JohnWSatterfield/Atlas_210X_Digital_VFO/Manual/readme

Atlas 210X Drake TR7 Crystal Filter.pdf is the name of the manual and instruction on how to convert your Atlas 210X to use a digital VFO.
CF.jpg is my drawing of the Drake crystal filter along with the parameters I selected for programming the microcontroller
Display_Bracket_Scale.pdf is a scaled pdf drawing that you can print to make the display bracket to mount the display into the radio,
and add the needed circuit boards.
