JohnWSatterfield/Atlas_210X_Digital_VFO/Manual/Display_Bracket_Scale.pdf

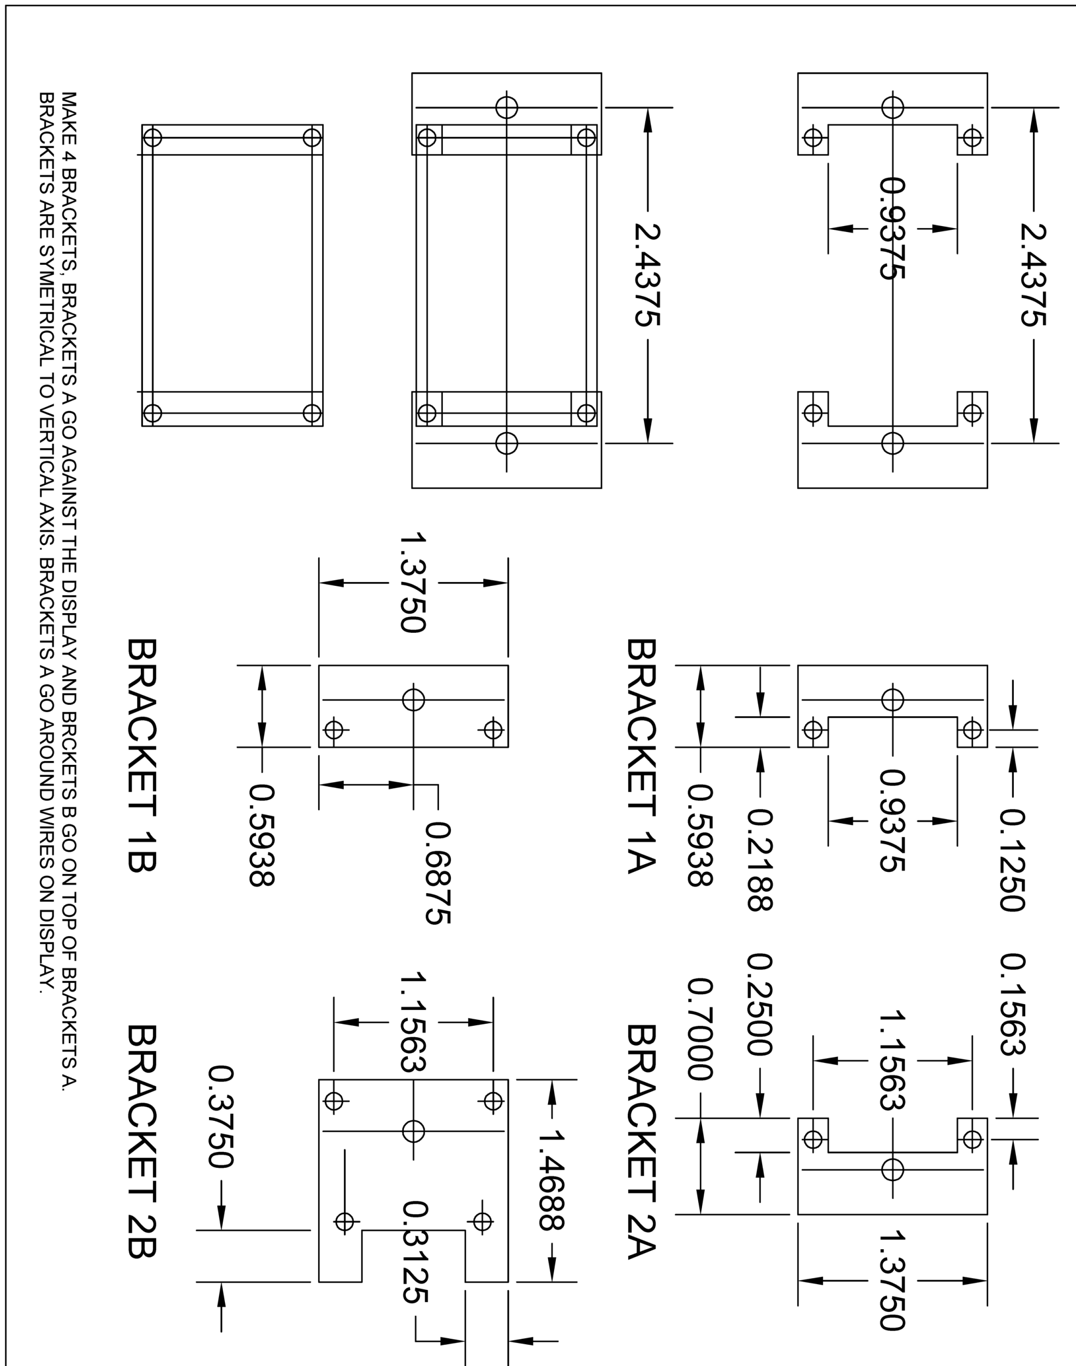
[picture p12: page 1]
