JohnWSatterfield/Atlas_210X_Digital_VFO/Manual/CF.jpg

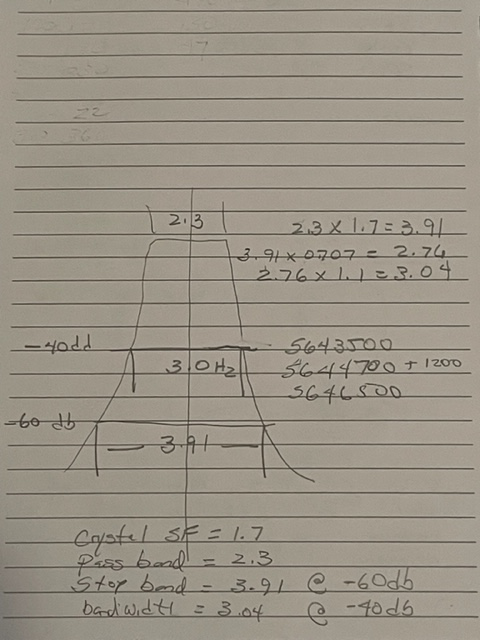
Manual/CF.jpg
